fussionko/esp32-temperature-controler/README.md

ESP32 temperature controler with temperature sensor on custom board.
Report includes circuit schematic, tools, and pictures.
